tomislavrekic/crkbd/README.md

# Corne keyboard - USB-C [WIP]

The Corne keyboard is a split keyboard with 3x6 column staggered keys
and 3 thumb keys, based on [Helix](https://github.com/MakotoKurauchi/helix).
Crkbd stands for Corne Keyboard.

v4

## Latest versions
- corne-cherry: for Cherry MX compatible switches

  - v4 Hotswappable ([JP](docs/corne-cherry/v4/buildguide_jp.md)/[EN](docs/corne-cherry/v4/buildguide_en.md))
  - v4 Soldering (will be released)
- corne-chocolate: for Kailh choc v1 and v2 switches
  - v4 Hotswappable ([JP](docs/corne-chocolate/v4/buildguide_jp.md)/[EN](docs/corne-chocolate/v4/buildguide_en.md)):
  - v4 Soldering (will be released)

## Old versions

- corne-classic: for Cherry MX compatible switches 
  - v1 Soldering: ([JP](docs/corne-classic/buildguide_jp.md)/[EN](docs/corne-classic/buildguide_en.md))
- corne-cherry: for Cherry MX compatible switches
  - v2 Hotswappable: ([JP](docs/corne-cherry/v2/buildguide_jp.md)/[EN](docs/corne-cherry/v2/buildguide_en.md))
  - v2 Hotswappable tilting version: ([tilting, JP](docs/corne-cherry/v2/buildguide_tilting_tenting_plate_jp.md)/[tilting, EN](docs/corne-cherry/v2/buildguide_tilting_tenting_plate_en.md)):
  - v3 Hotswappable: ([JP](docs/corne-cherry/v3/buildguide_jp.md)/[EN](docs/corne-cherry/v3/buildguide_en.md))
- corne-chocolate: for Kailh choc v1 switches
  - v2 Hotswappable: ([JP](docs/corne-chocolate/v2/buildguide_jp.md)/[EN](docs/corne-chocolate/v2/buildguide_en.md)):
- corne-light: for easy build with a simple PCB
  - v1 Soldering: ([JP](docs/corne-light/v1/buildguide_jp.md)/[EN](docs/corne-light/v1/buildguide_en.md)):
  - v2 Soldering: ([JP](docs/corne-light/v2/buildguide_low_edition_jp.md)/[EN](docs/corne-light/v2/buildguide_low_edition_en.md)):

## Notice
There are currently reports of a bug in v4.* caused by electromagnetic interference. Depending on the environment, one or both of the left and right keyboards may stop working. It is known that this is often caused by EMI emitted by mobile phones. If you experience this kind of problem, reconnect the USB, move the EMI-generating device (probably a mobile phone) more than 30 cm away from the keyboard, and observe the situation.

For more details, please see this issue. We look forward to receiving any new information.
https://github.com/foostan/crkbd/issues/265

## Images

### Cherry
corne-cherry



### Chocolate
corne-chocolate



### Drawing
sketche
