tomislavrekic/crkbd/(commit log)

2025-01-17 Split comms through USB-C. Added more ESD.
    Made a switch from TRS to USB-C for better ESD and short-circuit prevention. Added ferrite beads on external connections.
    [corne-cherry.kicad_sch, left.kicad_sch, right.kicad_sch]
2025-01-17 fixing tracks, silkscreen and some other DRC errors
2025-01-26 fixes and preparing for pcba
    [BOM-corne-cherry.csv, bom.csv, corne-cherry.kicad_sch, designators.csv, left.kicad_sch, positions.csv, right.kicad_sch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]
2025-02-28 Removed diode on split USB
    The diode blocked power to the other half of the keyboard.
    [bom.csv, designators.csv, left.kicad_sch, positions.csv, right.kicad_sch]
